1153015/Flipperkast/Flipperkast Elektrisch Schema.pdf

A

1 | 2 | 3 | 4 | 5 | 6

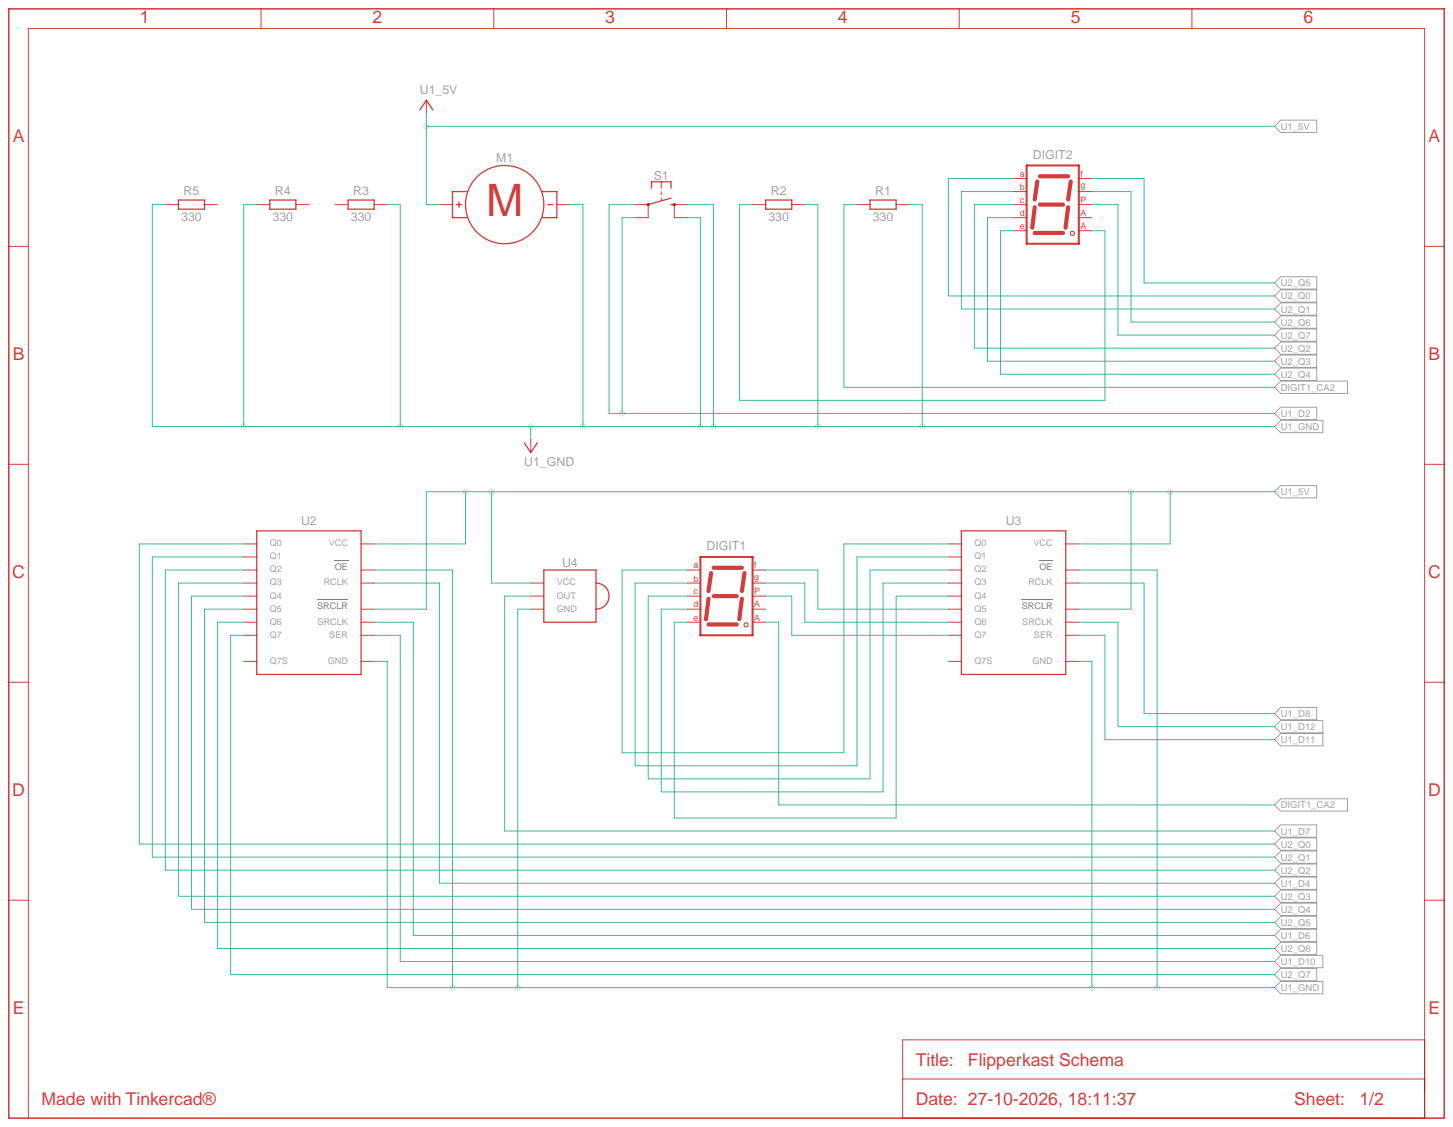
[picture p1: page 1]

A

1 | 2 | 3 | 4 | 5 | 6

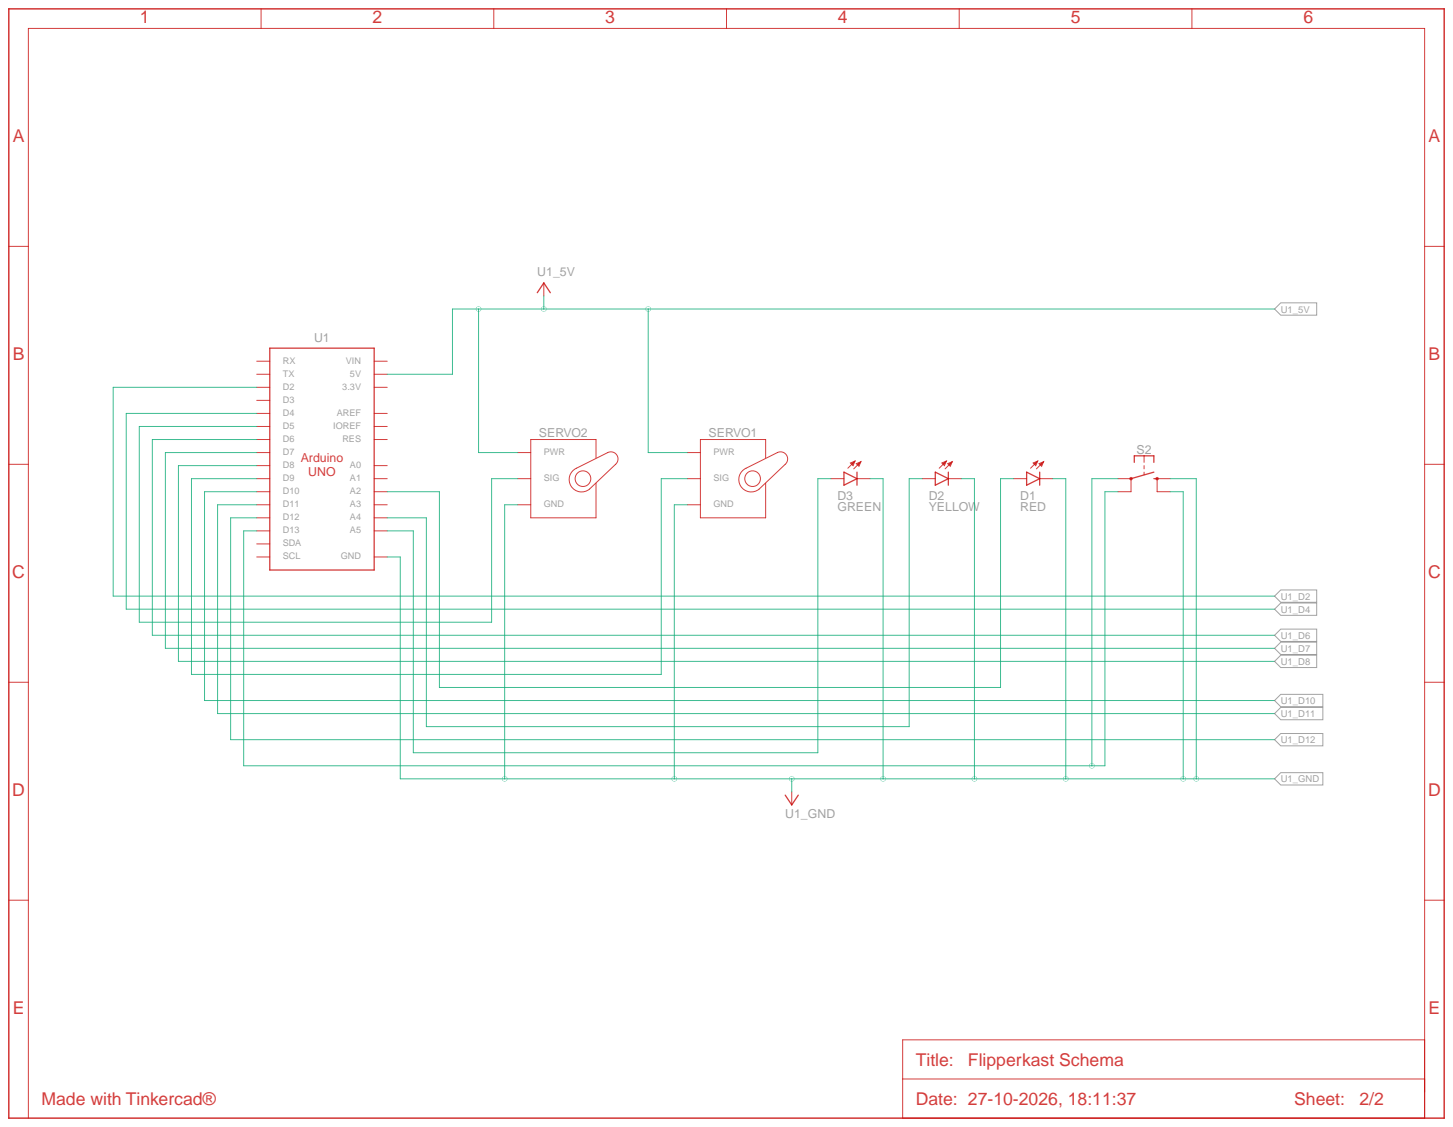
[picture p2: page 2]
